andy19588/aiot-final-project/conclusion_and_outlook.md

# 📊 ESP32 與 SCT-013 交流電流偵測系統：實驗結論與未來展望

本文件總結了本專案的實驗成果、所面臨的硬體與雜訊挑戰、解決方案，以及系統未來的擴充與應用展望。

---

## 🎓 1. 實驗結論 (Experimental Conclusion)

本專案成功實作了基於 **ESP32** 與 **SCT-013-000** 非侵入式電流感測器的交流電流與功率估算監測系統。透過軟硬體協同設計，我們解決了低電流量測解析度低與雜訊干擾等實作難題。

### 成果總結
1. **免函式庫高精度採樣**：利用 ESP32 的 `analogReadMilliVolts()` 直接讀取內部校正的電壓，成功避開了傳統模擬讀取（`analogRead()`）的非線性失真。
2. **動態連接偵測**：設計了基於「標準差（Standard Deviation）」的感測器物理連接判定演算法，當感測器拔除時可自動歸零電流並發出警告，避免懸空引腳的雜訊被誤判為電流。
3. **軟體高通濾波**：實作了數位一階高通濾波器，能自動且動態地濾除硬體分壓產生的 $1.65\text{V}$ 直流偏置，相較於傳統減去固定平均值的方式更具魯棒性。

---

## 🛠️ 2. 實驗過程中所遭遇的挑戰與限制

在實際搭建與測試電路的過程中，我們面臨了多項硬體物理特性、材料限制與雜訊干擾的挑戰：

### ⚠️ 挑戰一：簡易型比流器（CT）的物理量測限制
* **問題描述**：SCT-013-000 必須**單獨夾在火線（L）或中性線（N）**上。如果直接將感測器夾在包含兩條線的整根家電電源線（如常見的雙芯扁線）上，由於火線與中性線的電流方向相反，兩者產生的磁場會相互抵消，導致感測器輸出始終為 $0$。
* **解決方案**：必須製作一條「分線測試線」或在插座配線箱內將火線與中性線分離，以便感測器僅夾在單一導線上。這在消費級即插即用的應用上存在一定的物理限制。

### 📦 挑戰二：購買之電阻與電容規格偏離標準推薦值
在硬體採購與材料取得上，我們遇到了與經典教學設計不同的規格限制，但透過理論計算與代換，成功使系統正常運作：
* **負擔電阻（Burden Resistor）的代換**：
  * *經典規格*：一般量測大電流（~100A）時使用 $22\,\Omega$。
  * *本專案調整*：由於本次實驗目標為監測小功率家電（電風扇、筆電，通常 $< 2\text{A}$），若用 $22\,\Omega$ 產生的交流電壓訊號過於微弱（數個毫伏），會直接隱沒在底噪中。我們改用 **$1\text{k}\Omega$ 負擔電阻**，成功將信號放大 **45 倍**，在小電流下仍保有極佳的 ADC 解析度。
  * *代價*：最大安全電流量測範圍被限制在 **$2.33\text{A RMS}$** 左右，若接入高功率負載（如吹風機）會有燒毀晶片的風險。
* **濾波電容（Filter Capacitor）的不足**：
  * *經典規格*：通常使用 $10\mu\text{F}$ 左右的電解電容來穩定分壓中點。
  * *本專案調整*：由於採購限制，本實驗僅使用 **$104$ 瓷片電容 ($0.1\mu\text{F}$)**。雖然 $0.1\mu\text{F}$ 對 60Hz 交流信號的阻抗較高（約 $26.5\text{k}\Omega$），對低頻干擾的旁路效果較差，但我們透過**軟體高通濾波演算法**在後端完美補償了這個硬體缺憾，並透過並聯電容進行局部強化。

### 📡 挑戰三：複雜的電子雜訊處理
ESP32 的 ADC 性能與內建 Wi-Fi 模組在運作時會帶來較大的電磁雜訊，特別是類比訊號的零點漂移。我們主要透過以下手段進行濾除：
1. **硬體端**：選用受 Wi-Fi 射頻干擾最少的類比通道一（ADC1）的 **GPIO 34**。
2. **軟體高通濾波（HPF）**：每隔 $100\mu\text{s}$ 進行高速採樣，並透過數位高通濾波公式：
   $$y[n] = 0.9961 \times (y[n-1] + x[n] - x[n-1])$$
   即時將 1.65V 的直流偏壓成分濾除。
3. **軟體雜訊門檻（Noise Gate）**：當計算出的 RMS 電流小於 `NOISE_GATE_A = 0.05A`（約 5.5W @ 110V）時，自動強行歸零。此舉成功消除了無負載時因 ADC 微小抖動所產生的「虛假電流」。

---

## 🚀 3. 未來展望 (Future Outlook)

基於目前已實作完成的電流監測基礎，本系統在未來具有極高的智慧化擴充潛力：

### 💡 應用一：智慧自動化負載監測與主動防護 (Auto Load Shedding)
* **自動偵測與關閉冗餘電器**：可結合 ESP32 的 GPIO 控制繼電器（Relay）或與智慧插座（Smart Plug）連線。當系統偵測到特定電器已長時間處於低電流待機狀態（例如電視、電腦螢幕未關），可主動切斷電源以節省能耗。
* **超載與安全防護**：若量測到的電流突然異常飆高，可即時關閉繼電器並透過 LINE Notify 或簡訊發出警報，防止電線過載引發火災。

### 🌐 應用二：物聯網與雲端數據儀表板 (IoT Integration)
* **雲端平台整合**：透過 ESP32 內建的 Wi-Fi 模組，使用 **MQTT 協定** 或 **HTTP POST** 將電流與功率數據即時上傳至物聯網雲端平台（如 ThingsSpeak、Adafruit IO、Firebase 或自建的 Home Assistant）。
* **歷史數據視覺化**：結合 Prometheus 與 Grafana 繪製家電用電曲線，分析日/月/年的累積用電量（kWh），計算出家電的碳排放量與電費估算。

### 🧠 應用三：非侵入式電力負載監測與特徵辨識 (NILM)
* **單一感測器辨識多個電器**：目前系統只能測量總電流。未來可以導入機器學習演算法（如支持向量機 SVM 或微型神經網絡 TinyML），在 ESP32 或邊緣端分析電流與電壓的波形特徵（如啟動時的暫態湧浪電流、諧波特徵）。
* **智慧家電診斷**：即使只在總電源線上夾一個 SCT-013 感測器，系統亦能自動識別「目前是吹風機被打開，還是冰箱壓縮機在運轉」，實現低成本的智慧家庭用電監測。
