andy19588/aiot-final-project/conversation_log.md

# 對話紀錄：SCT-013 電路元件替換與低電流優化

**日期：** 2026-05-26  
**專案：** ESP32 + SCT-013-000 交流電流偵測系統

---

## 👤 使用者提問

現在有幾個問題
1. 沒有22歐姆電阻，但有1k, 1.2k, 10k歐姆電阻
2. 電容最低只有104電容可用
3. 當SCT不連接，完全拔除時，也會跑出數值，測試Serial.print(analogRead(ADC_PIN)), 得到1975上下浮動的數值
4. 我現在只想處理如電扇、筆電等電器的電流，請給出更符合該環境條件的電阻、電容推薦

---

## 🤖 AI 回覆

我已經完整了解你的專案和四個問題。讓我進行分析並提供完整的建議。

## 分析

### 你的使用場景（電風扇、筆電充電器）
- 電風扇：30~80W → **0.27A ~ 0.73A** @ 110V
- 筆電充電器：45~100W → **0.41A ~ 0.91A** @ 110V
- 最大可能電流約 **2A** 左右

### Burden 電阻分析

用 **1kΩ** 電阻作為 burden resistor 是最佳選擇：

| 項目 | 22Ω (原設計) | 1kΩ (推薦) |
|---|---|---|
| 最大可量測電流 | 106A | **2.33A** |
| 1A 時的信號電壓 | 11mV (很小) | **500mV (大)** |
| 0.5A 時的 ADC 解析度 | ~7 steps | **~312 steps** |
| 雜訊等效電流 | 高 | **低 (1/45)** |
| 適合場景 | 工業/大電流 | **家電/小電流** ✅ |

### 問題 3 分析（SCT 拔除時讀到 ~1975）
ADC 讀到 1975/4095 × 3.3V ≈ **1.59V**，這就是偏壓電路的 1.65V。因為 burden 電阻把偏壓點連到 GPIO 34，所以即使 SCT 拔除，ADC 仍會讀到偏壓。改用 1kΩ 後，雜訊等效電流會大幅下降，加上調高的 noise gate 就能正確歸零。

讓我更新你的程式碼和文件：

### 程式碼修改（sct013_esp32.ino）

以下為修改的差異：

```diff
@@ 參數設定 @@
-const double BURDEN_RESISTOR = 22.0;   // 負擔電阻阻值 (單位：歐姆 Ω)，常用 22Ω 或 10Ω
+const double BURDEN_RESISTOR = 1000.0; // 負擔電阻阻值 (單位：歐姆 Ω)。使用 1kΩ 電阻，適合量測 0~2.33A 的低電流家電 (電扇、筆電等)

-const double NOISE_GATE_A = 0.08;              // 雜訊門檻 (單位：安培 A)，若計算出的電流低於此值則歸零，防止無負載時的數值飄移
+const double NOISE_GATE_A = 0.05;              // 雜訊門檻 (單位：安培 A)。使用 1kΩ 負擔電阻時雜訊很低，0.05A 即可有效濾除
```

```diff
@@ setup() @@
   Serial.println(F("ESP32 + SCT-013-000 電流偵測程式啟動中..."));
+  Serial.println(F("(低電流家電優化版 - 電扇/筆電適用)"));
   ...
+  // 計算並顯示最大可量測電流
+  double maxCurrent = (1.65 / sqrt(2.0)) / BURDEN_RESISTOR * CT_RATIO;
+  Serial.print(F("最大可量測電流: ")); Serial.print(maxCurrent, 2); Serial.println(F(" A RMS"));
+  Serial.print(F("雜訊門檻: ")); Serial.print(NOISE_GATE_A, 3); Serial.println(F(" A"));
```

```diff
@@ loop() @@
-  double Irms = readCurrentRMS();
+  // 檢測 SCT-013 是否連接
+  bool sctConnected = isSCTConnected();
+  
+  double Irms = 0.0;
+  if (sctConnected) {
+    Irms = readCurrentRMS();
+  }
   ...
+  if (!sctConnected) {
+    Serial.println("[警告] SCT-013 未連接或未偵測到信號");
+  }
```

新增 `isSCTConnected()` 函式：

```cpp
/**
 * @brief 檢測 SCT-013 是否已連接
 * @return bool true 表示已連接，false 表示未連接
 * 
 * 原理：當 SCT 未連接時，ADC 透過 burden 電阻讀到穩定的偏壓 (~1650mV)，
 * 讀數變異量極小。當 SCT 已連接（即使無負載），環境中的電磁雜訊
 * 會讓讀數有明顯的 AC 變異。我們利用短時間取樣的標準差來區分。
 */
bool isSCTConnected() {
  const int CHECK_SAMPLES = 50;
  double sum = 0;
  double sumSq = 0;
  
  for (int i = 0; i < CHECK_SAMPLES; i++) {
    double v = (double)analogReadMilliVolts(ADC_PIN);
    sum += v;
    sumSq += v * v;
    delayMicroseconds(200);
  }
  
  double mean = sum / CHECK_SAMPLES;
  double variance = (sumSq / CHECK_SAMPLES) - (mean * mean);
  double stddev = sqrt(variance);
  
  // 當 SCT 未連接時，標準差通常 < 2mV（只有 ADC 本身的量化噪音）
  // 當 SCT 已連接時，即使無負載，60Hz 環境耦合也會讓標準差 > 5mV
  // 使用 3mV 作為門檻值（可依實際環境微調）
  return (stddev > 3.0);
}
```

---

## 👤 使用者

Continue

---

## 🤖 AI 回覆

程式碼已更新完成，現在來更新 README.md 文件，把零件清單和電路圖改成你實際可用的元件：

### README.md 主要修改內容

#### 零件清單更新

```diff
-* **22 Ω 負擔電阻 (Burden Resistor)** ×1 (1/4W 或以上，建議精密金屬膜電阻)
+* **1 kΩ 負擔電阻 (Burden Resistor)** ×1 (1/4W 或以上)

-* **10 μF 電解電容** ×1 (濾波、穩定偏置電壓用)
+* **104 瓷片電容 (0.1μF)** ×1 (濾波、穩定偏置電壓用。若有多顆 104 可並聯 2~3 顆以增強濾波效果)
```

#### 電路圖更新

```
                    3.3V (ESP32)
                       │
                     ┌─┴─┐
                     │10k│ 分壓電阻 R1
                     └─┬─┘
                       ├─────────────────┐
                       │                 │
                       ├──────┐          │
                       │    ┌─┴──┐     ┌─┴──┐
                       │    │1kΩ │     │104 │ 濾波電容 C1 (0.1μF)
                       │    └─┬──┘     └─┬──┘
     SCT-013           │      │          │
     3.5mm 插頭        │      │          │
   ┌───────────┐       │      │          │
   │ Sleeve ───┼───────┴──────┼──────────┴────── GND (ESP32)
   │ (S端/套筒) │              │
   │           │              │
   │  Tip ─────┼──────────────┴───────────────── GPIO 34 (ESP32 ADC)
   │ (T端/前端) │
   └───────────┘
```

#### 新增低電流優化版設計推導

**使用 1kΩ 負擔電阻的量測範圍：**

| 一次側電流 (A) | 二次側電流 (mA) | Burden 電壓 (mV) | ADC 峰值範圍 (V) | 安全? |
|:---:|:---:|:---:|:---:|:---:|
| 0.5 | 0.25 | 250 | 1.30 ~ 2.00 | ✅ |
| 1.0 | 0.50 | 500 | 0.94 ~ 2.36 | ✅ |
| 1.5 | 0.75 | 750 | 0.59 ~ 2.71 | ✅ |
| 2.0 | 1.00 | 1000 | 0.24 ~ 3.06 | ✅ |
| **2.33** | **1.167** | **1167** | **0.07 ~ 3.23** | ✅ (極限) |
| 3.0 | 1.50 | 1500 | -0.47 ~ 3.77 | ❌ **超範圍** |

#### ADC 解析度比較（22Ω vs 1kΩ）

| 一次側電流 (A) | 22Ω Burden 信號 (mV) | 1kΩ Burden 信號 (mV) | 解析度提升 |
|:---:|:---:|:---:|:---:|
| 0.3 (小電扇) | 3.3 | **150** | **45x** |
| 0.5 (電扇) | 5.5 | **250** | **45x** |
| 0.7 (筆電) | 7.7 | **350** | **45x** |
| 1.0 (大筆電) | 11.0 | **500** | **45x** |

#### 電容選擇說明（104 電容）

原設計使用 10μF 電解電容，其在 60Hz 下的阻抗約 265Ω，可有效旁路偏壓中點的 AC 雜訊。

使用 104 (0.1μF) 電容時，60Hz 下的阻抗約 26.5kΩ，旁路效果較弱。但由於：
1. **數位高通濾波器** 會在軟體層面濾除所有 DC 偏移
2. **1kΩ burden 產生較大信號**，信噪比本身就高
3. 104 電容仍可有效濾除 **高頻雜訊**（kHz 以上）

因此 0.1μF 在本應用中是可行的。若想進一步改善，可**並聯 2~3 顆 104 電容**。

#### 新增 SCT 連接偵測機制說明

| 狀態 | ADC 讀數特性 | 標準差 |
|:---:|:---|:---:|
| SCT **未連接** | 極穩定，只有 ADC 量化噪音 | < 2 mV |
| SCT **已連接**（無負載） | 60Hz 環境電磁耦合造成微小波動 | > 5 mV |
| SCT **已連接**（有負載） | 明顯的 60Hz 交流信號 | >> 10 mV |

#### 新增常見問題 (FAQ)

**Q1: SCT 拔除時 Serial 顯示非零電流？**
程式已內建連接偵測功能，會自動判別並輸出 `[警告] SCT-013 未連接或未偵測到信號`，電流歸零。若仍有殘餘數值，可適當調高 `NOISE_GATE_A` 的值。

**Q2: 可以量測吹風機/電熱水瓶嗎？**
不建議。1kΩ burden 的最大安全電流為 ~2.33A（約 256W @ 110V）。若需量測更大電流，請改用更小的 burden 電阻。可用的替代方案：
- 兩顆 1kΩ **並聯** → 500Ω → 最大 ~4.67A（約 513W）
- 兩顆 1.2kΩ **並聯** → 600Ω → 最大 ~3.89A（約 428W）

**Q3: 只有 104 電容，濾波效果夠嗎？**
104 (0.1μF) 可以工作，但濾波效果不如 10μF。建議：
- **並聯 2~3 顆** 104 電容以增強效果
- 程式中的數位高通濾波器會補償不足的硬體濾波

---

## 修改總覽

### 🔧 問題 1 & 4：電阻推薦 → **使用 1kΩ**

| | 原設計 (22Ω) | 新設計 (1kΩ) |
|---|---|---|
| 最大可量測電流 | 106A | **2.33A** (夠用) |
| 0.5A 電扇的信號 | 5.5mV (極小) | **250mV** ✅ |
| 1A 筆電的信號 | 11mV | **500mV** ✅ |
| ADC 解析度提升 | 基準 | **45 倍** |

對電扇/筆電來說，22Ω 的信號太小，被雜訊淹沒；1kΩ 把信號放大 45 倍，精度大幅提升。

### 🔧 問題 2：電容推薦 → **104 (0.1μF) 可行**

- 0.1μF 的高頻濾波仍有效，配合程式中的**數位高通濾波器**可補償
- 建議**並聯 2~3 顆 104** 電容以增強效果

### 🔧 問題 3：SCT 拔除時浮動數值 → **已加入自動偵測**

- ADC 讀到 ~1975 是正常的（burden 電阻把 1.65V 偏壓傳到 GPIO 34）
- 新增 `isSCTConnected()` 函式，透過**標準差判斷**是否已接 SCT
- 未連接時自動歸零並顯示 `[警告] SCT-013 未連接或未偵測到信號`

### 📋 需要的零件清單（最終版）

| 零件 | 規格 | 數量 |
|---|---|---|
| 負擔電阻 | **1kΩ** | 1 |
| 分壓電阻 | 10kΩ | 2 |
| 濾波電容 | **104 (0.1μF)** | 1~3 (並聯) |
