andy19588/aiot-final-project/基於 ESP32 之邊緣運算智慧能源監測與非侵入式電力控制系統.pdf

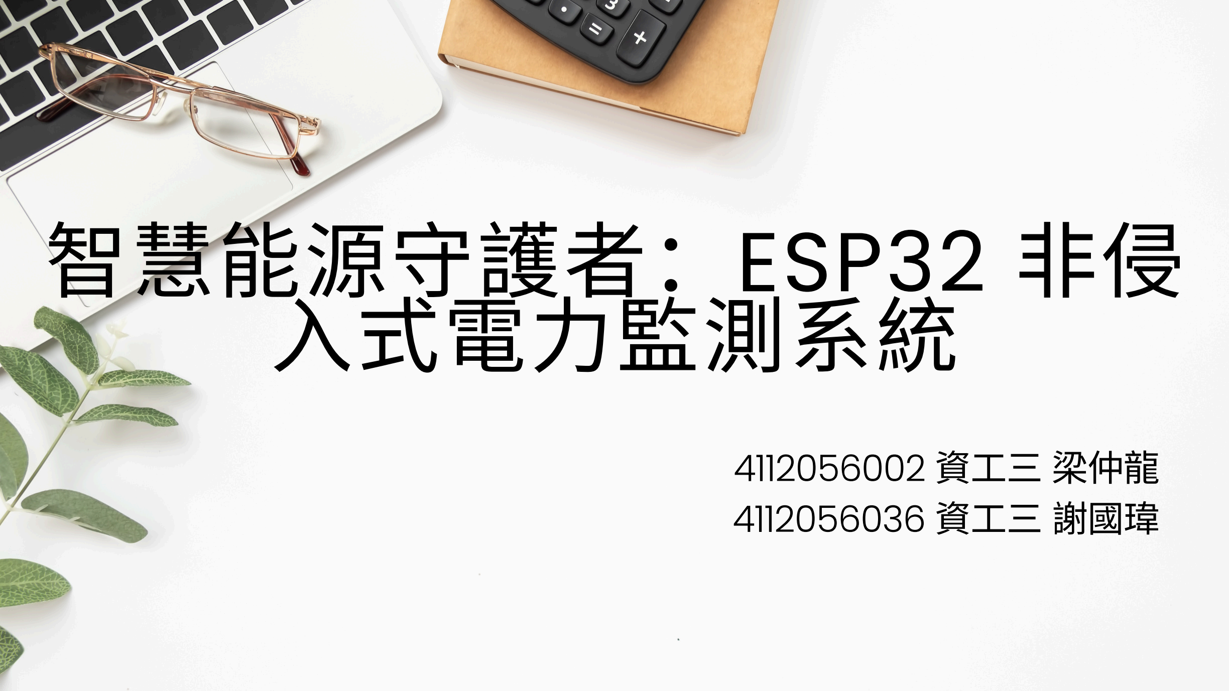
[picture p8: page 1]

# 智慧能源守護者：ESP32 非侵 入式電⼒監測系統

4112056002 資工三 梁仲⿓

4112056036 資工三 謝國瑋

目錄

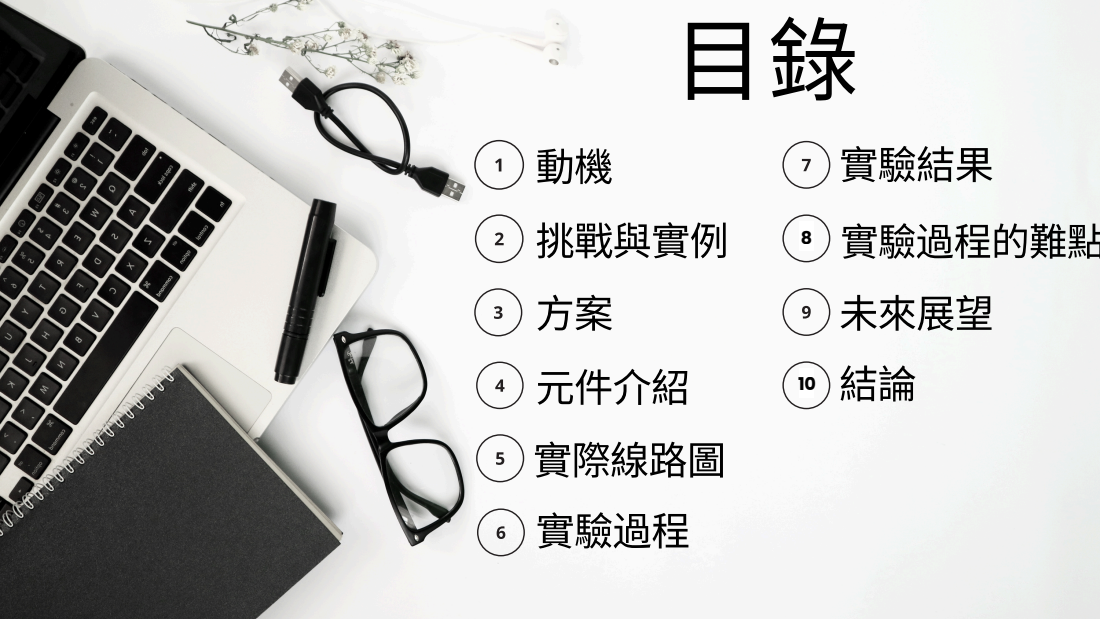
[picture p9: page 2]
挑戰與實例; 元件介紹; 實際線路圖; 實驗過程; 實驗結果; 實驗過程的難點; 未來展望

動機

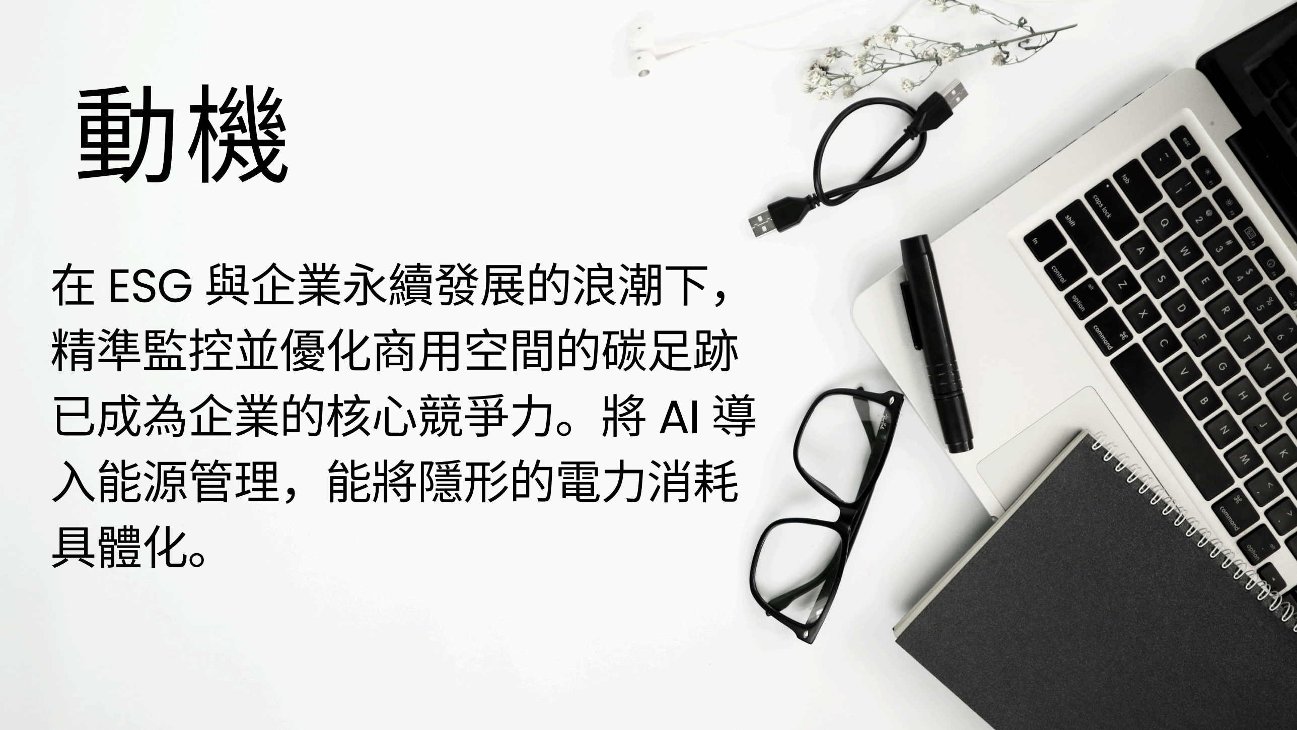
[picture p10: page 3]

在 ESG 與企業永續發展的浪潮下，
精準監控並優化商用空間的碳足跡
已成為企業的核心競爭力。將 AI 導
入能源管理，能將隱形的電力消耗
具體化。

# 挑戰與實例

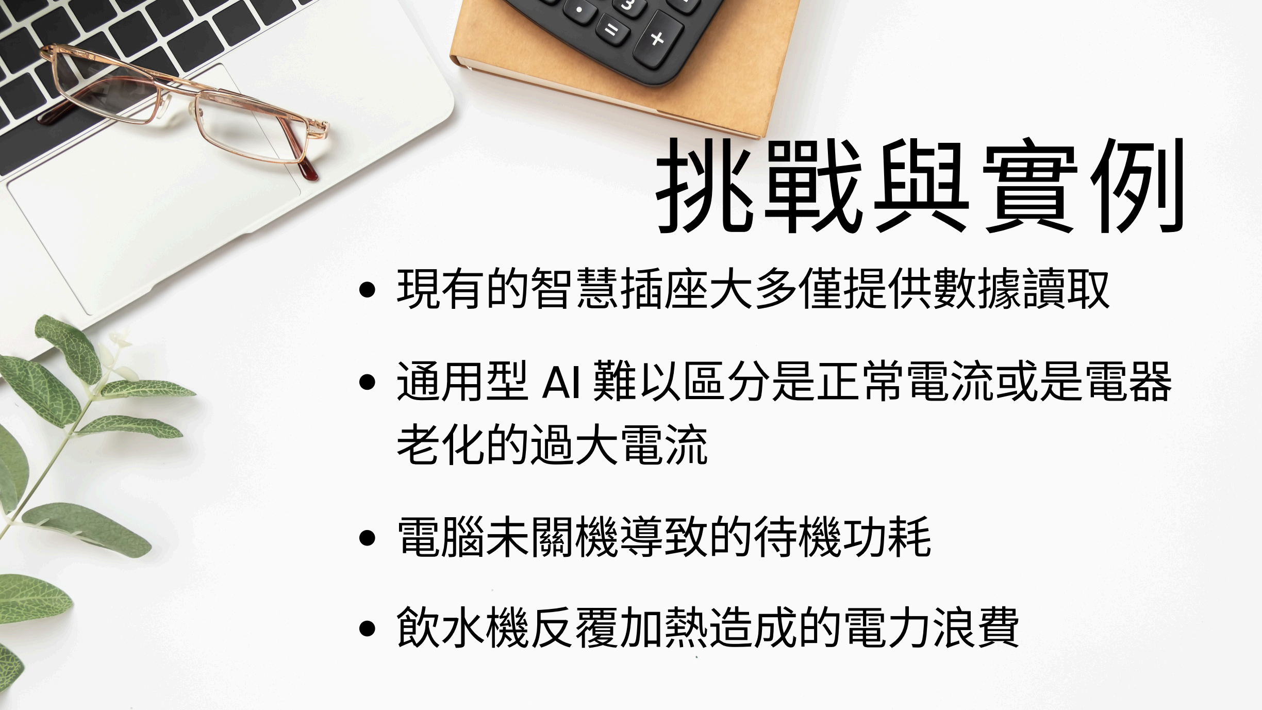
[picture p11: page 4]

現有的智慧插座大多僅提供數據讀取

通用型 AI 難以區分是正常電流或是電器
老化的過⼤電流

電腦未關機導致的待機功耗

飲水機反覆加熱造成的電⼒浪費

方案

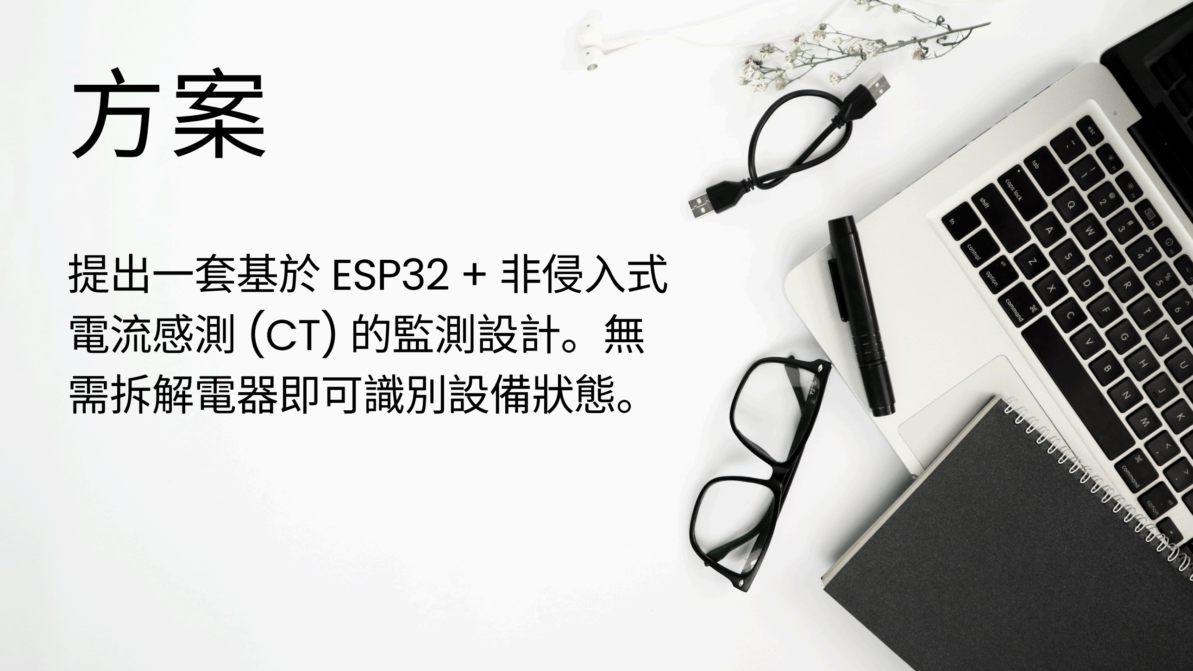
[picture p12: page 5]

提出一套基於 ESP32 + 非侵入式
電流感測 (CT) 的監測設計。無
需拆解電器即可識別設備狀態。

元

件

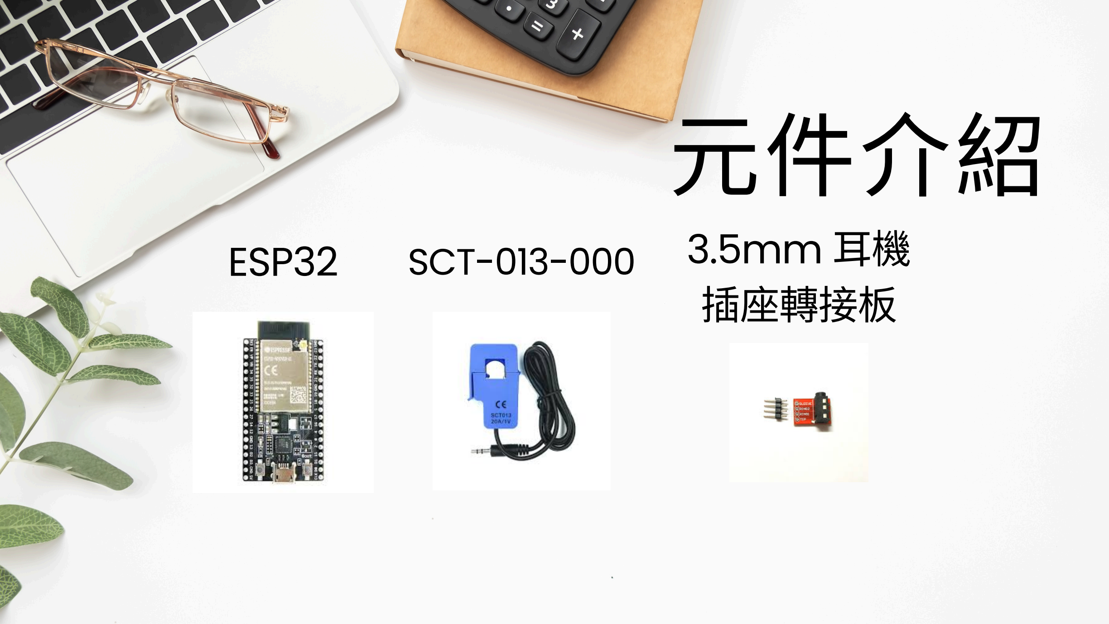
[picture p13: page 6]

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
# 實際線路圖

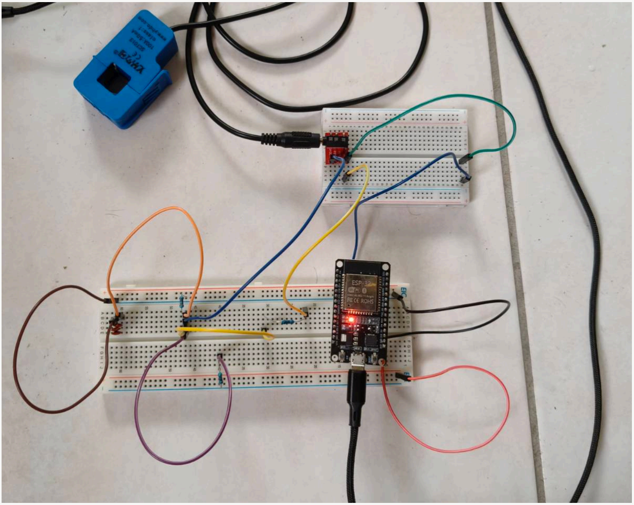
[picture p14: figure]

# 實驗過程圖

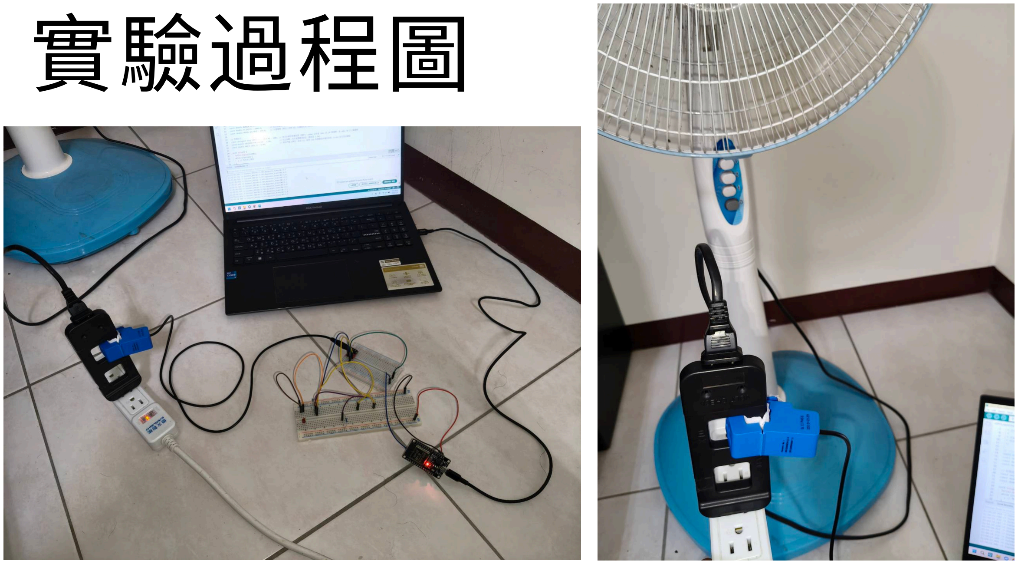
[picture p15: page 8]

# 實驗結果說明

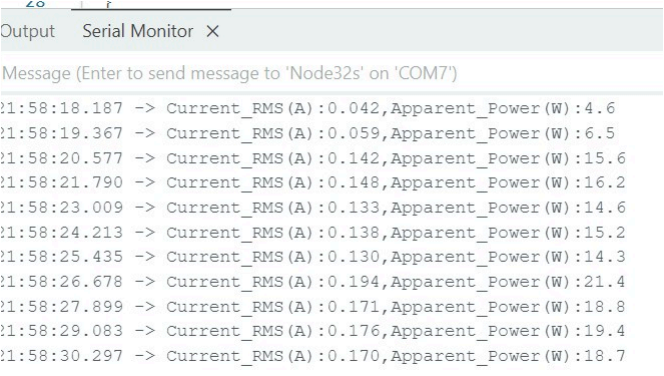
[picture p16: figure]

# 實驗過程的困難

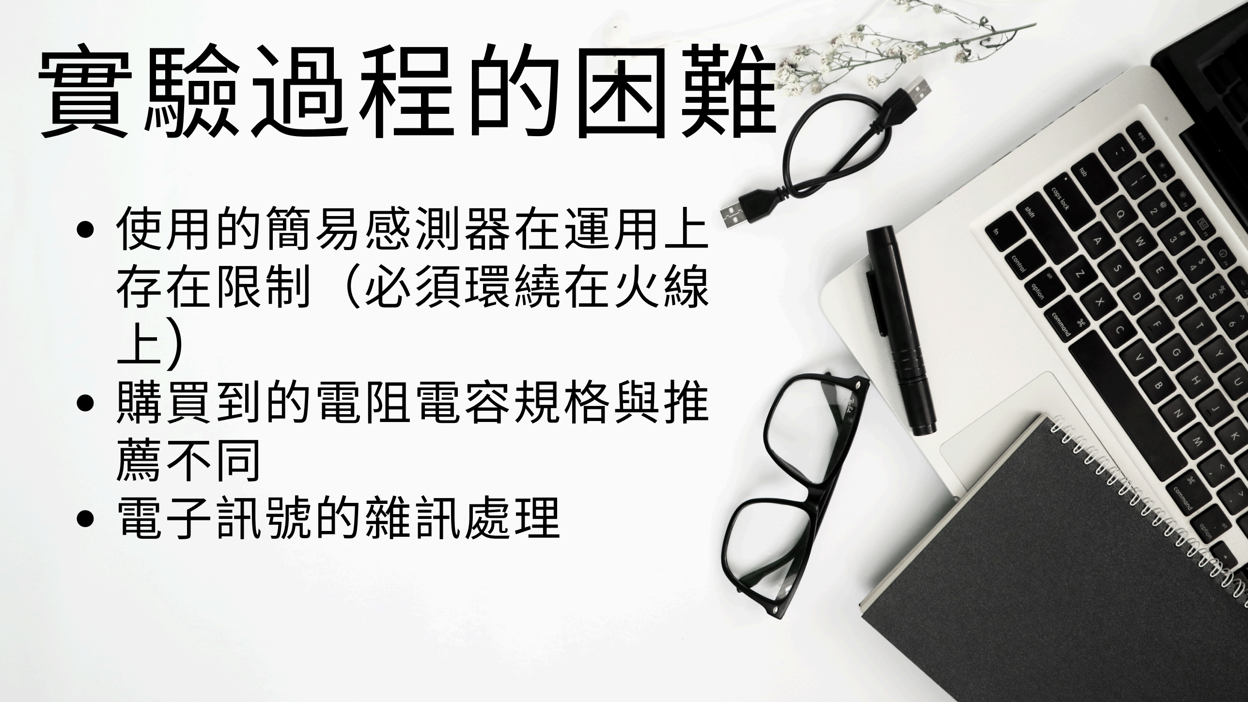
[picture p17: page 10]

使用的簡易感測器在運用上
存在限制（必須環繞在火線
上)
購買到的電阻電容規格與推
薦不同
電子訊號的雜訊處理

# 未來展望

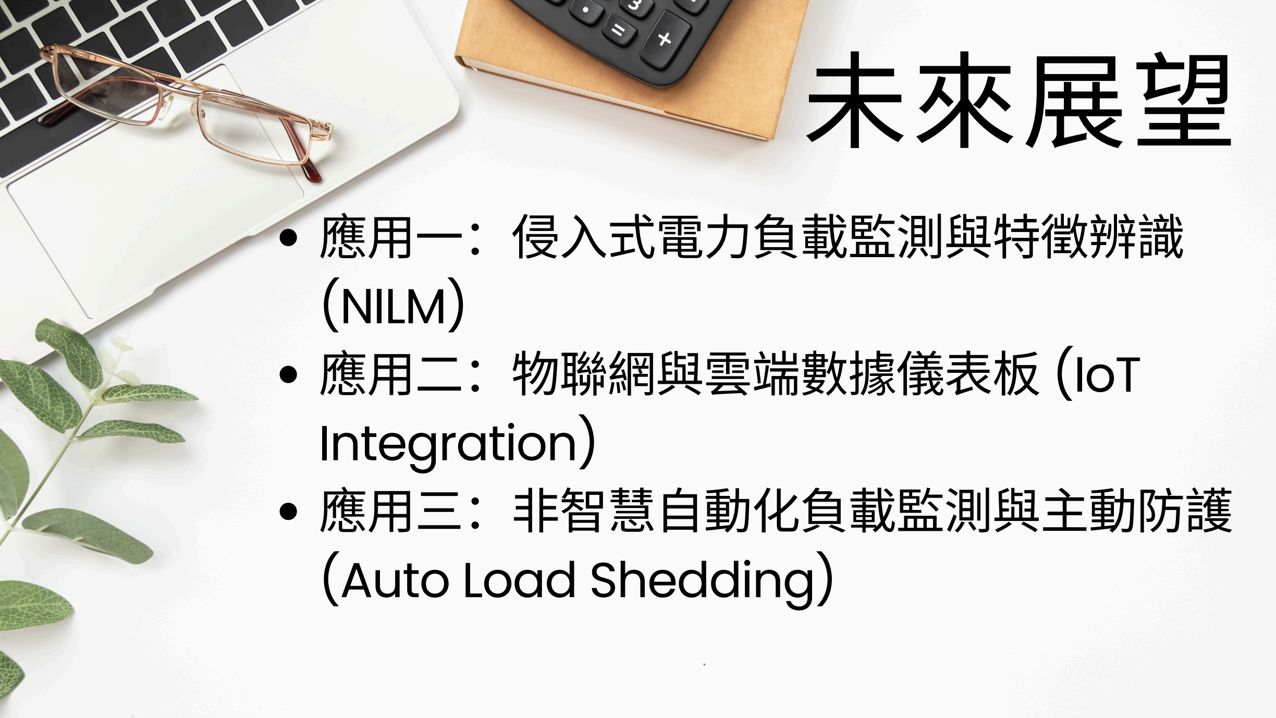
[picture p18: page 11]

應用一：侵入式電力負載監測與特徵辨識

## (NILM)

應用二：物聯網與雲端數據儀表板 (IoT

## Integration)

應用三：非智慧自動化負載監測與主動防護

## (Auto Load Shedding)

結論

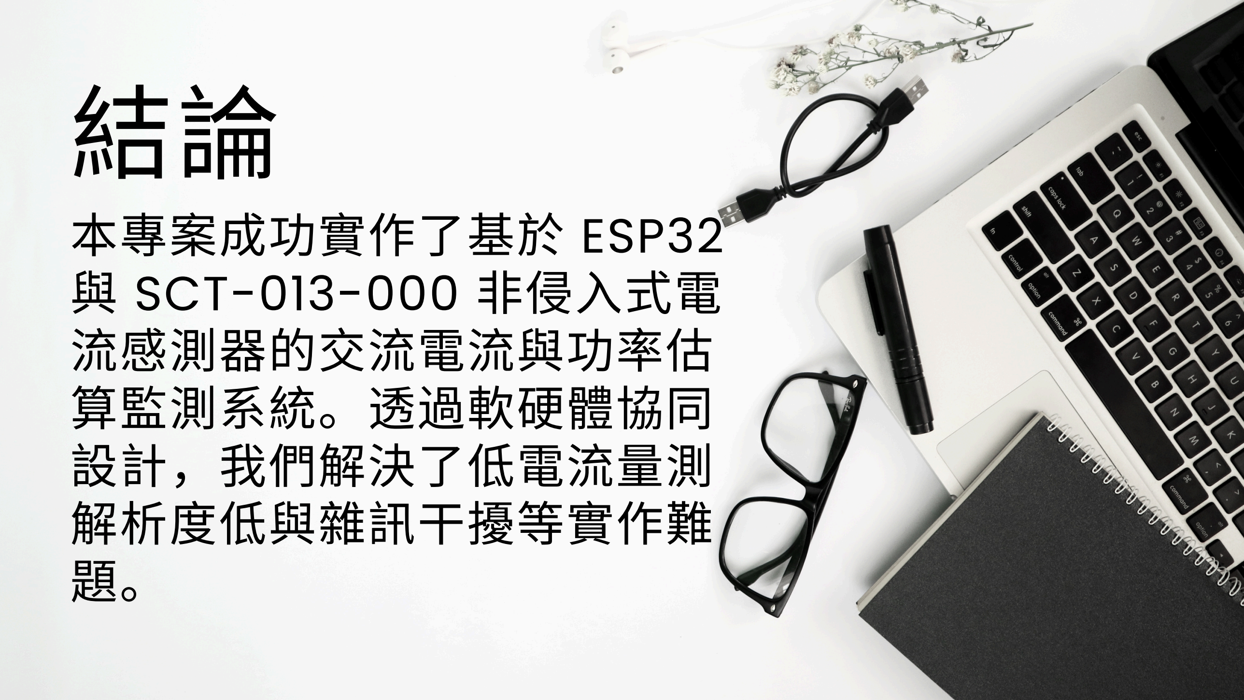
[picture p19: page 12]

本專案成功實作了基於 ESP32

## 與 SCT-013-000 非侵入式電

流感測器的交流電流與功率估
算監測系統。透過軟硬體協同
設計，我們解決了低電流量測
解析度低與雜訊干擾等實作難
題。

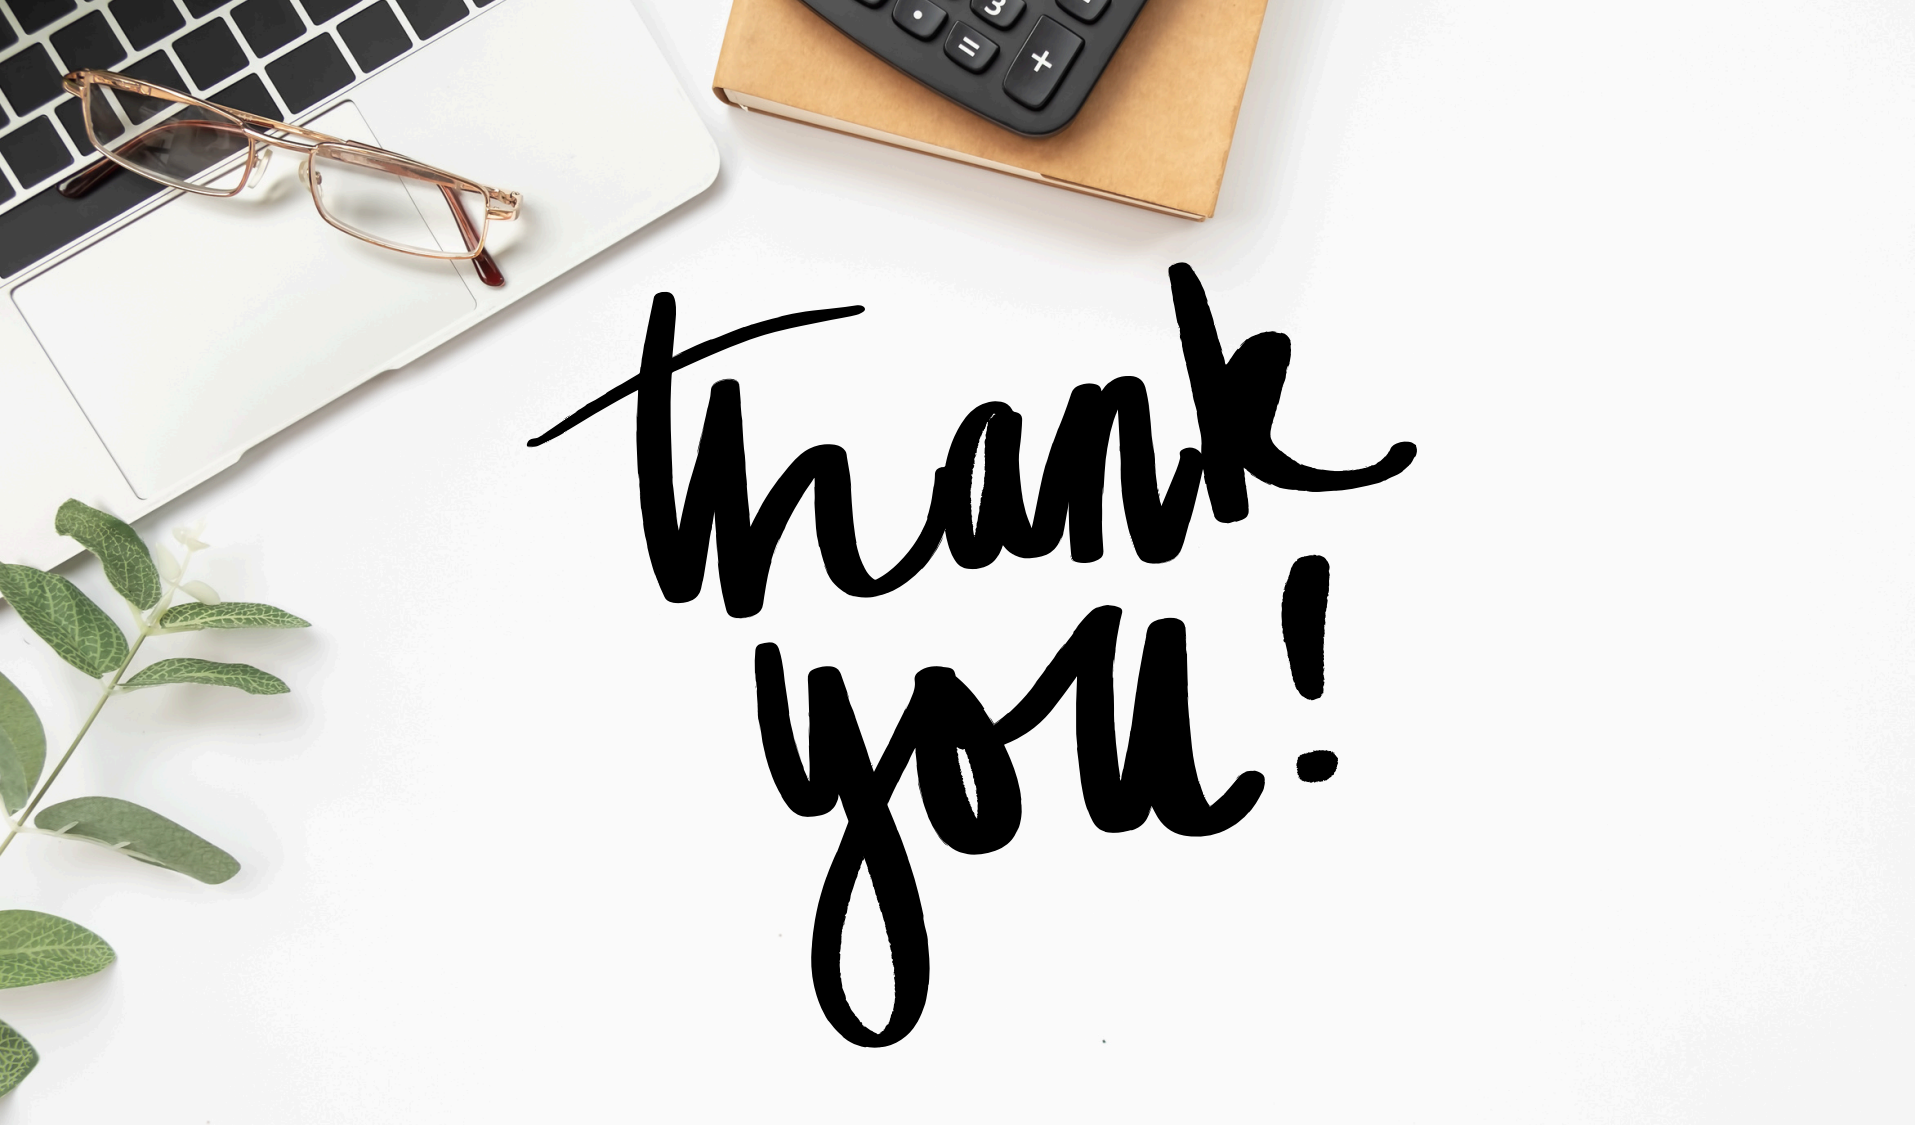
[picture p20: page 13]
